SHexplorer/Studienarbeit/PCB/BOM_PCB_Studienarbeit Multicopter Sensorkit_2023-04-14.csv

ID | Name | Designator | Footprint | Quantity | Manufacturer Part | Manufacturer | Supplier | Supplier Part | Price
1 | PZ200V-11-04P | TH02-HEADER,HP206C-HEADER | HDR-TH_4P-P2.00-V-M | 2 | PZ200V-11-04P | XFCN(兴飞) | LCSC | C541858 | 0.003
2 | GROVE - TH02 - TEMP HUM | U7 | SHE-GROVE - TH02 - HUM TEMP | 1 |  |  | SeeedStudio | undefined
3 | GROVE - HP206C - BAROMETER | U6 | SHE-GROVE - HP206C - BAROMETER | 1 |  |  | SeeedStudio | undefined
4 | SHE-SDS011-Header | SDS011 | HDR-TH_4P-P2.54-V-F-2 | 1 | 2.54-1*6P母 | BOOMELE(博穆精密) | LCSC | C40877 | 0.011
5 | Arduino Pro Mini | ARDUINOPROMINI1 | ARDUINO_PRO_MINI_GB | 1 | ?
6 | 8650 Li Ion | BAT1 | BATTERY_18650-HOLDER | 1 | ?
7 | Sensor Luminosidad | LIGHTSENSOR | ADAFRUIT TSL2591 | 1 | Adafruit | Adafruit | Adafruit | 1980
8 | IP5306 | M1 | IP5306MODULE-LIION-SHE-FOOTPRINT | 1 | IP5306 Module | LantianRC | LantianRC | IP5306Mod
9 | 5VIN | P2 | DG301-5.0-2P | 1 | DG301-5.0-2P |  | Degson | DG301-5.0-2P
10 | Adafruit Feather 32u4 Radio with RFM69HCW Module | U1 | ADAFRUIT-FEATHER-32U4-RFM-LORA | 1
11 | ADAFRUIT MCP9808 | U2 | ADAFRUIT MCP9808 | 1
12 | CCS811 | U3 | CCS811-1 | 1 | CCS811
13 | Adafruit 5V ready Micro-SD breakout | U4 | MICRO-SD_BREAKOUT | 1 | 254 | Adafruit | Adafruit
14 | SHE-UVM30A-Header | UV | HDR-TH_3P-P2.54-V-M-1 | 1 | 2.54-1*3 | ZHOURI(洲日) | LCSC | C5116482 | 0.009
15 | SHE-GPS-EM-406A-Header | GPS | HDR-TH_6P-P2.54-V-F | 1 | 2.54-1*6P母 | BOOMELE(博穆精密) | LCSC | C40877 | 0.011
16 | SM06B-SRSS-TB(LF)(SN) | U5 | CONN-SMD_SM06B-SRSS-TB-LF-SN | 1 | SM06B-SRSS-TB(LF)(SN) | JST | LCSC | C160405 | 0.033
